joaoreser/Projeto-pcb-CRAO-Multifiltro/BOM_/AUTOOSCILANTE_BOM.xlsx

Name | Description | Designator | Footprint | LibRef | Quantity | Manufacturer | MPN | Supplier | Supplier P/N | Comments
~ | Capacitor de filme PP (FKP) – tanque ressonante (Cr) | C1, C2, C3, C4 | C_Rect_L18.0mm_W5.0mm_P15.00mm_FKS3_FKP3 | C_Small | 4 | WIMA | Série FKP3 (def. p/ valor) | Mouser | Definir conforme valor | Capacitores do tanque ressonante (Cr) — filme de polipropileno (FKP), passo 15 mm, alta tensão. Sugestão típica ~22 nF/630 V; valor final definido pelo projeto do conversor ressonante (algum deles pode ser bloqueio CC).
1uF | Capacitor de filme (MKS) 1 µF – filtro do barramento Vbus | C5 | C_Rect_L31.5mm_W11.0mm_P27.50mm_MKS4 | C_Small | 1 | WIMA | MKS4, 1 µF (conf. tensão) | Mouser | Buscar MKS4 1µF/630V | Capacitor de filtro do barramento Vbus, filme de poliéster (MKS4). Tensão nominal ≥ tensão do barramento (provavelmente 630 V).
~ | Capacitor de filme – filtro/snubber | C6 | C_Rect_L10.0mm_W4.0mm_P7.50mm_MKS4 | C_Small | 1 | WIMA | Série MKS4 (def. p/ valor) | Mouser | Definir conforme valor | Capacitor de filme pequeno (passo 7,5 mm). Valor a definir pelo esquemático (ex.: 100 nF).
C_Polarized_Small | Capacitor eletrolítico SMD – fonte auxiliar | C7, C8 | CP_Elec_6.3x5.7 | C_Polarized_Small | 2 | Panasonic | EEE-1HA100SR (10 µF/50 V) – conf. | Mouser | 667-EEE-1HA100SR (conf.) | Capacitor eletrolítico SMD (Ø6,3 mm) de filtro da alimentação/fonte auxiliar. Valor a confirmar (ex.: 10 µF/50 V).
~ | Capacitor cerâmico 0805 – desacople/filtro | C9, C11, C12, C13, C14, C15, C16, C17, C18, C19, C20 | C_0805_2012Metric_Pad1.18x1.45mm_HandSolder | C_Small | 11 | Yageo | CC0805KRX7R9BB104 (100 nF/50 V) | Mouser | 603-CC0805KRX7R9BB104 | Cerâmicos de desacople/filtro do controle (padrão 100 nF/50 V X7R). Atenção: alguns têm valor específico — ex.: filtro de saída do ACS712 (~1 nF, ver datasheet) e capacitores do L7805. Confirmar valores no esquemático.
C_Small | Capacitor cerâmico 1206 – bloco de partida | C10 | C_1206_3216Metric_Pad1.33x1.80mm_HandSolder | C_Small | 1 | Yageo | CC1206KKX7R9BB105 (1 µF/50 V) – conf. | Mouser | 603-CC1206KKX7R9BB105 (conf.) | Cerâmico 1206 (bloco de partida, junto à SW1). Valor a confirmar (ex.: 1 µF/50 V).
C_Polarized_Small | Capacitor eletrolítico radial – filtro de saída (Co) | Co1, Co2, Co3, Co4 | CP_Radial_D10.0mm_P5.00mm | C_Polarized_Small | 4 | Nichicon | UPW2A101MPD (100 µF/100 V) – conf. | Mouser | 647-UPW2A101MPD (conf.) | Capacitores eletrolíticos do filtro de saída (Co), radial Ø10 mm. Capacitância/tensão conforme Vo e ondulação desejada; tensão ≥ ~1,5× Vo (ex.: 4×100 µF/100 V).
D_Zener_Small_Filled | Diodo Zener (MELF) – grampo de gate | D1, D3, D8, D11 | D_MELF-RM10_Universal_Handsoldering | D_Zener_Small_Filled | 4 | Vishay | BZM55C15 (Zener 15 V, MELF) – conf. | Mouser | Buscar Zener MELF 15 V (conf.) | Diodos Zener de grampo dos gates do meio-ponte (HS/LS). Tensão típica 15 V (ajustar ao nível de gate/Vcc). Encapsulamento MELF.
D_Small_Filled | Diodo ultrarrápido (SMA) – gate / fonte aux. / controle | D2, D5, D6, D9, D12 | D_SMA_Handsoldering | D_Small_Filled | 5 | onsemi | US1M (ultrarrápido, 1 A/1000 V) | Mouser | 863-US1M | Diodos ultrarrápidos 1 A (SMA). D2/D9: acionamento de gate; D5/D6: retificação da fonte auxiliar; D12: controle. Para os de gate pode-se usar Schottky rápido (ex.: SS14) se a tensão reversa for baixa.
D_Small_Filled | Diodo retificador 1N4007 (DO-41) – partida | D4 | D_DO-41_SOD81_P7.62mm_Horizontal | D_Small_Filled | 1 | onsemi | 1N4007G | Mouser | 863-1N4007G | Diodo retificador 1000 V/1 A (DO-41) do circuito de partida (alimenta o startup a partir do Vbus).
DIAC | DIAC (DO-35) – disparo da partida | D7 | D_DO-35_SOD27_P7.62mm_Horizontal | DIAC | 1 | STMicroelectronics | DB3 | Mouser | 511-DB3 | DIAC de disparo da partida do oscilador (tensão de breakover ≈ 30–32 V). Encapsulamento DO-35.
D_Zener_Small_Filled | Diodo Zener (SMA) – regulação da Vcc auxiliar | D10 | D_SMA_Handsoldering | D_Zener_Small_Filled | 1 | onsemi | 1SMA5929BT3G (Zener 15 V/1,5 W) – conf. | Mouser | 863-1SMA5929BT3G (conf.) | Zener de regulação/grampo da tensão de alimentação auxiliar Vcc (≈15 V). Confirmar tensão conforme o projeto da fonte auxiliar.
D_Small_Filled | Diodo ultrarrápido (SMC) – retificador de saída | DR1, DR2, DR3, DR4 | D_SMC-RM10_Universal_Handsoldering | D_Small_Filled | 4 | onsemi | ES3J (ultrarrápido 3 A/600 V) – conf. | Mouser | 863-ES3J (conf.) | Diodos do retificador de saída em ponte completa (SMC/DO-214AB). Ultrarrápido 3 A/600 V; rever corrente/tensão conforme a saída. Alternativa Schottky (ex.: SK34/STPS) se Vo for baixa.
GND | Furo de fixação M3 – mecânico | H1, H2, H3, H4 | MountingHole_3.2mm_M3_Pad_Via | MountingHole_Pad | 4 | N/A | — | N/A | N/A | Furo de fixação M3 (Ø3,2 mm) com ilha/via — recurso mecânico da PCB, não é componente a comprar. Usar parafuso/espaçador M3.
Conn_01x02 | Terminal Faston PCB – saída | J1, J3 | Faston_5mm | Conn_01x02 | 2 | Keystone Electronics | 1287 (terminal Faston PCB) – conf. | Mouser | 534-1287 (conf.) | Terminal Faston de PCB para a saída (Vo / I+). Confirmar largura da lâmina (4,8 vs 6,3 mm) conforme o conector usado.
Vbus | Terminal Faston PCB – entrada Vbus | J2 | Faston_5mm | Conn_01x02 | 1 | Keystone Electronics | 1287 (terminal Faston PCB) – conf. | Mouser | 534-1287 (conf.) | Terminal Faston de PCB para a entrada do barramento Vbus (+).
GND | Terminal Faston PCB – GND | J4 | Faston_5mm | Conn_01x02 | 1 | Keystone Electronics | 1287 (terminal Faston PCB) – conf. | Mouser | 534-1287 (conf.) | Terminal Faston de PCB para GND/retorno.
Conn_01x02 | Borne a parafuso 2 vias, passo 5,08 mm | J5, J6 | KRE02 | Conn_01x02 | 2 | Phoenix Contact | 1715022 (MKDS 1,5/2-5,08) | Mouser | 651-1715022 | Borne a parafuso de 2 vias, passo 5,08 mm (J5: alimentação auxiliar externa; J6: sinal/saída do bloco). Alternativa econômica: KF301-5.0-2P (LCSC).
iR | Jumper de medição de corrente (iR) | JP1 | Jumper_Corrente_1mm | SolderJumper_2_Open | 1 | N/A | — | N/A | N/A | Jumper de medição de corrente "iR" — abrir o laço para inserir a ponteira de corrente, ou fechar com solda/0 Ω. Recurso de PCB (não é componente comprado).
iD1 | Jumper de medição de corrente (iD1) | JP2 | Jumper_Corrente_1mm | SolderJumper_2_Open | 1 | N/A | — | N/A | N/A | Jumper de medição de corrente "iD1" — abrir o laço para inserir a ponteira de corrente, ou fechar com solda/0 Ω. Recurso de PCB (não é componente comprado).
iSec | Jumper de medição de corrente (iSec) | JP3 | Jumper_Corrente_1mm | SolderJumper_2_Open | 1 | N/A | — | N/A | N/A | Jumper de medição de corrente "iSec" — abrir o laço para inserir a ponteira de corrente, ou fechar com solda/0 Ω. Recurso de PCB (não é componente comprado).
iD2 | Jumper de medição de corrente (iD2) | JP4 | Jumper_Corrente_1mm | SolderJumper_2_Open | 1 | N/A | — | N/A | N/A | Jumper de medição de corrente "iD2" — abrir o laço para inserir a ponteira de corrente, ou fechar com solda/0 Ω. Recurso de PCB (não é componente comprado).
SolderJumper_2_Open | Jumper de solda – configuração | JP5 | Jumper_Corrente_1mm | SolderJumper_2_Open | 1 | N/A | — | N/A | N/A | Jumper de solda de configuração — fechar/abrir conforme a montagem. Recurso de PCB (não é componente comprado).
iS1 | Jumper de medição de corrente (iS1) | JP6 | Jumper_Corrente_1mm | SolderJumper_2_Open | 1 | N/A | — | N/A | N/A | Jumper de medição de corrente "iS1" — abrir o laço para inserir a ponteira de corrente, ou fechar com solda/0 Ω. Recurso de PCB (não é componente comprado).
iS2 | Jumper de medição de corrente (iS2) | JP7 | Jumper_Corrente_1mm | SolderJumper_2_Open | 1 | N/A | — | N/A | N/A | Jumper de medição de corrente "iS2" — abrir o laço para inserir a ponteira de corrente, ou fechar com solda/0 Ω. Recurso de PCB (não é componente comprado).
~ | Indutor ressonante (Lr) – núcleo EFD25, fab. própria | L1 | EFD_25_13_09_PIN-1-2-10 | L | 1 | TDK / Ferroxcube (núcleo) + fab. própria | Núcleo EFD25/13/9 (N87/3C90) + carretel | Mouser (núcleo) | Definir (núcleo + carretel) | Indutor ressonante (Lr) — núcleo EFD25/13/9 em ferrite (ex.: TDK N87 / Ferroxcube 3C90) com carretel de 10 pinos. Bobinar conforme cálculo (indutância, nº de espiras, entreferro). Fabricação própria.
NMOS | MOSFET N 600 V (DPAK) – meio-ponte | M1, M2 | TO-252-2 | NMOS | 2 | onsemi (alt. Infineon) | FQD7N60CTF (600 V/7 A, DPAK) | Mouser | 512-FQD7N60CTF (conf.) | MOSFETs do meio-ponte (HS/LS), 600 V em DPAK/TO-252. Confirmar Rds(on)/corrente conforme a potência. Para LLC recomenda-se superjunção (ex.: Infineon CoolMOS IPD60R…P7).
BC817 | Transistor NPN BC817 (SOT-23) | Q1, Q2 | SOT-23 | BC817 | 2 | Nexperia | BC817-40,215 | Mouser | 771-BC817-40215 | Transistores NPN de uso geral (SOT-23, 45 V/0,5 A). Q1: regulação da alimentação auxiliar; Q2: bloco de controle.
~ | Resistor SMD 1206 – diversos (partida / leitura) | R1, R2, R3, R4, R5, R7, R8, R10, R11, R13, R14, R15, R21, R24, R25, R27, R38, R39 | R_1206_3216Metric_Pad1.30x1.75mm_HandSolder | R_Small | 18 | Yageo | Série RC1206 (def. p/ valor) | Mouser | Definir conforme valor | Resistores 1206 (0,25 W), valores a definir pelo esquemático. Inclui os de partida de alta tensão (R2/R5/R11 — alto valor; verificar tensão de trabalho) e o divisor de leitura de saída (R4/R10/R15). Tolerância 1% recomendada.
~ | Resistor SMD 0805 – acionamento de gate | R6, R9, R12, R17, R19, R20 | R_0805_2012Metric_Pad1.20x1.40mm_HandSolder | R_Small | 6 | Yageo | Série RC0805 (def. p/ valor) | Mouser | Definir conforme valor | Resistores 0805, valores a definir. Posições de acionamento de gate (R6/R9 e R12/R17/R19/R20) — tipicamente 10–47 Ω. Confirmar no esquemático.
10R | Resistor SMD 1206 – 10 Ω | R16, R44 | R_1206_3216Metric_Pad1.30x1.75mm_HandSolder | R_Small | 2 | Yageo | RC1206FR-0710RL (10 Ω, 1%) | Mouser | 603-RC1206FR-0710RL | Resistores 10 Ω/1206. R16: limitação/leitura na fonte auxiliar; R44: bloco de controle.
3k6 | Resistor SMD 0805 – 3,6 kΩ | R18 | R_0805_2012Metric_Pad1.20x1.40mm_HandSolder | R_Small | 1 | Yageo | RC0805FR-073K6L (3,6 kΩ, 1%) | Mouser | 603-RC0805FR-073K6L | Resistor 3,6 kΩ/0805 (polarização da fonte auxiliar — junto ao Q1/Zener).
10R | Resistor SMD 0805 – malha de controle | R22, R23, R26, R28, R29, R30, R31, R32, R33, R34, R35, R36, R37, R40, R41, R42, R43, R45, R46, R47, R48 | R_0805_2012Metric_Pad1.20x1.40mm_HandSolder | R_Small | 21 | Yageo | RC0805FR-0710RL (10 Ω) – ver obs. | Mouser | 603-RC0805FR-0710RL | ATENÇÃO: 21 resistores 0805 marcados como "10 Ω" — provavelmente é o valor padrão do Altium ainda não editado. Na malha de controle (ganhos dos amp. op., divisores, referência, dimming) os valores normalmente são diferentes (ex.: 1k–100k). Conferir/atualizar cada valor no esquemático antes de comprar; o MPN segue o valor real.
R_Potentiometer_Small | Trimpot multivoltas 3296W – ajustes | RV1, RV2 | Potentiometer_Bourns_3296W_Vertical | R_Potentiometer_Small | 2 | Bourns | 3296W-1-103LF (10 kΩ) – conf. | Mouser | 652-3296W-1-103LF (conf.) | Trimpots multivoltas 3296W (vertical). RV1: ajuste de corrente máxima ("SET Max"); RV2: ajuste de dimming/referência. Resistência conforme projeto (ex.: 10 kΩ ou 100 kΩ).
SW_Push | Chave tátil 6 mm – partida / reset | SW1 | SW_SPST_PTS645 | SW_Push | 1 | C&K | PTS645SK50SMTR92 LFS – conf. | Mouser | 611-PTS645SK50SMTR92 (conf.) | Chave tátil 6 mm (partida/reset manual). Alternativa: tact 6×6 mm genérico (LCSC).
VdHS | Ponto de teste (laço) – VdHS | TP1 | TestPoint_Loop_D1.80mm_Drill1.0mm_Beaded | TestPoint_Probe | 1 | Keystone Electronics | 5011 (ponto de teste de laço) | Mouser | 534-5011 | Ponto de teste (laço) para medição — sinal "VdHS" (ver coluna Value). Pode ser substituído por um laço de fio soldado.
Rac1 | Ponto de teste (laço) – Rac1 | TP2 | TestPoint_Loop_D1.80mm_Drill1.0mm_Beaded | TestPoint_Probe | 1 | Keystone Electronics | 5011 (ponto de teste de laço) | Mouser | 534-5011 | Ponto de teste (laço) para medição — sinal "Rac1" (ver coluna Value). Pode ser substituído por um laço de fio soldado.
VgHS | Ponto de teste (laço) – VgHS | TP3 | TestPoint_Loop_D1.80mm_Drill1.0mm_Beaded | TestPoint_Probe | 1 | Keystone Electronics | 5011 (ponto de teste de laço) | Mouser | 534-5011 | Ponto de teste (laço) para medição — sinal "VgHS" (ver coluna Value). Pode ser substituído por um laço de fio soldado.
Rac2 | Ponto de teste (laço) – Rac2 | TP4 | TestPoint_Loop_D1.80mm_Drill1.0mm_Beaded | TestPoint_Probe | 1 | Keystone Electronics | 5011 (ponto de teste de laço) | Mouser | 534-5011 | Ponto de teste (laço) para medição — sinal "Rac2" (ver coluna Value). Pode ser substituído por um laço de fio soldado.
VsHS | Ponto de teste (laço) – VsHS | TP5 | TestPoint_Loop_D1.80mm_Drill1.0mm_Beaded | TestPoint_Probe | 1 | Keystone Electronics | 5011 (ponto de teste de laço) | Mouser | 534-5011 | Ponto de teste (laço) para medição — sinal "VsHS" (ver coluna Value). Pode ser substituído por um laço de fio soldado.
VdLS | Ponto de teste (laço) – VdLS | TP6 | TestPoint_Loop_D1.80mm_Drill1.0mm_Beaded | TestPoint_Probe | 1 | Keystone Electronics | 5011 (ponto de teste de laço) | Mouser | 534-5011 | Ponto de teste (laço) para medição — sinal "VdLS" (ver coluna Value). Pode ser substituído por um laço de fio soldado.
VgLS | Ponto de teste (laço) – VgLS | TP7 | TestPoint_Loop_D1.80mm_Drill1.0mm_Beaded | TestPoint_Probe | 1 | Keystone Electronics | 5011 (ponto de teste de laço) | Mouser | 534-5011 | Ponto de teste (laço) para medição — sinal "VgLS" (ver coluna Value). Pode ser substituído por um laço de fio soldado.
VsLS | Ponto de teste (laço) – VsLS | TP8 | TestPoint_Loop_D1.80mm_Drill1.0mm_Beaded | TestPoint_Probe | 1 | Keystone Electronics | 5011 (ponto de teste de laço) | Mouser | 534-5011 | Ponto de teste (laço) para medição — sinal "VsLS" (ver coluna Value). Pode ser substituído por um laço de fio soldado.
Earth | Ponto de teste (laço) – Earth | TP9 | TestPoint_Loop_D1.80mm_Drill1.0mm_Beaded | TestPoint_Probe | 1 | Keystone Electronics | 5011 (ponto de teste de laço) | Mouser | 534-5011 | Ponto de teste (laço) para medição — sinal "Earth" (ver coluna Value). Pode ser substituído por um laço de fio soldado.
GND | Ponto de teste (laço) – GND | TP10 | TestPoint_Loop_D1.80mm_Drill1.0mm_Beaded | TestPoint_Probe | 1 | Keystone Electronics | 5011 (ponto de teste de laço) | Mouser | 534-5011 | Ponto de teste (laço) para medição — sinal "GND" (ver coluna Value). Pode ser substituído por um laço de fio soldado.
y | Pad de teste SMD – y | TP11 | Test Pad SMD | TestPoint_Probe | 1 | N/A | — | N/A | N/A | Pad de teste SMD do controle — sinal "y" (ver coluna Value). Sem componente a montar.
erro | Pad de teste SMD – erro | TP12 | Test Pad SMD | TestPoint_Probe | 1 | N/A | — | N/A | N/A | Pad de teste SMD do controle — sinal "erro" (ver coluna Value). Sem componente a montar.
ref | Pad de teste SMD – ref | TP13 | Test Pad SMD | TestPoint_Probe | 1 | N/A | — | N/A | N/A | Pad de teste SMD do controle — sinal "ref" (ver coluna Value). Sem componente a montar.
TRX_LLC_16pin | Transformador LLC – núcleo EE35, fab. própria | TR1 | EE_35_18_12 | TRX_LLC_16pin_2aux | 1 | TDK / Ferroxcube (núcleo) + fab. própria | Núcleo EE35/18/12 (N87/3C90) + carretel 16 pinos | Mouser (núcleo) | Definir (núcleo + carretel) | Transformador principal do conversor LLC — núcleo EE35/18/12 em ferrite, carretel de 16 pinos. Primário + secundário + 2 enrolamentos auxiliares; relação de espiras, Lm e Lr conforme projeto. Fabricação própria.
L7805 | Regulador linear +5 V L7805 (DPAK) | U1 | TO-252-3_TabPin2 | L7805 | 1 | STMicroelectronics | L7805CDT-TR | Mouser | 511-L7805CDT-TR | Regulador linear +5 V (DPAK) — alimenta o ACS712 e parte do controle.
ACS712xLCTR-05B | Sensor de corrente Hall ACS712 ±5 A (SOIC-8) | U2 | SOIC-8_3.9x4.9mm_P1.27mm | ACS712xLCTR-05B | 1 | Allegro MicroSystems | ACS712ELCTR-05B-T | Mouser | 634-ACS712ELCTR-05B-T | Sensor de corrente por efeito Hall, faixa ±5 A, sensibilidade ~185 mV/A (SOIC-8). Mede a corrente de saída.
Opamp_Quad | Amp. operacional quádruplo (SOIC-14) – controlador | U3 | SOIC-14_3.9x8.7mm_P1.27mm | Opamp_Quad | 1 | Texas Instruments | LM324DR | Mouser | 595-LM324DR | Amplificador operacional quádruplo do controlador (U3A–U3D: malha de erro, condicionamento da corrente, dimming 0–10 V). Para excursão rail-to-rail em 5 V, considerar MCP6004/TLV9004.
VCT | Transformador de corrente (VCT) – 2 toroides, fab. própria | VCT1 | Toroidal_2xD12.5mm_VCT | CT_LP_LS1_LS2_Laux | 1 | Fair-Rite / Ferroxcube (toroides) + fab. própria | 2× toroide de ferrite Ø12,5 mm | Mouser (toroides) | Definir (toroides) | Transformador de corrente (VCT) do acionamento autooscilante — 2 toroides de ferrite Ø12,5 mm. Gera o sinal de comando do meio-ponte a partir da corrente do tanque; relação de espiras conforme projeto. Fabricação própria.
