joaoreser/Projeto-pcb-CRAO-Multifiltro/Pdf_esquematico/Esquematico_PCB.pdf

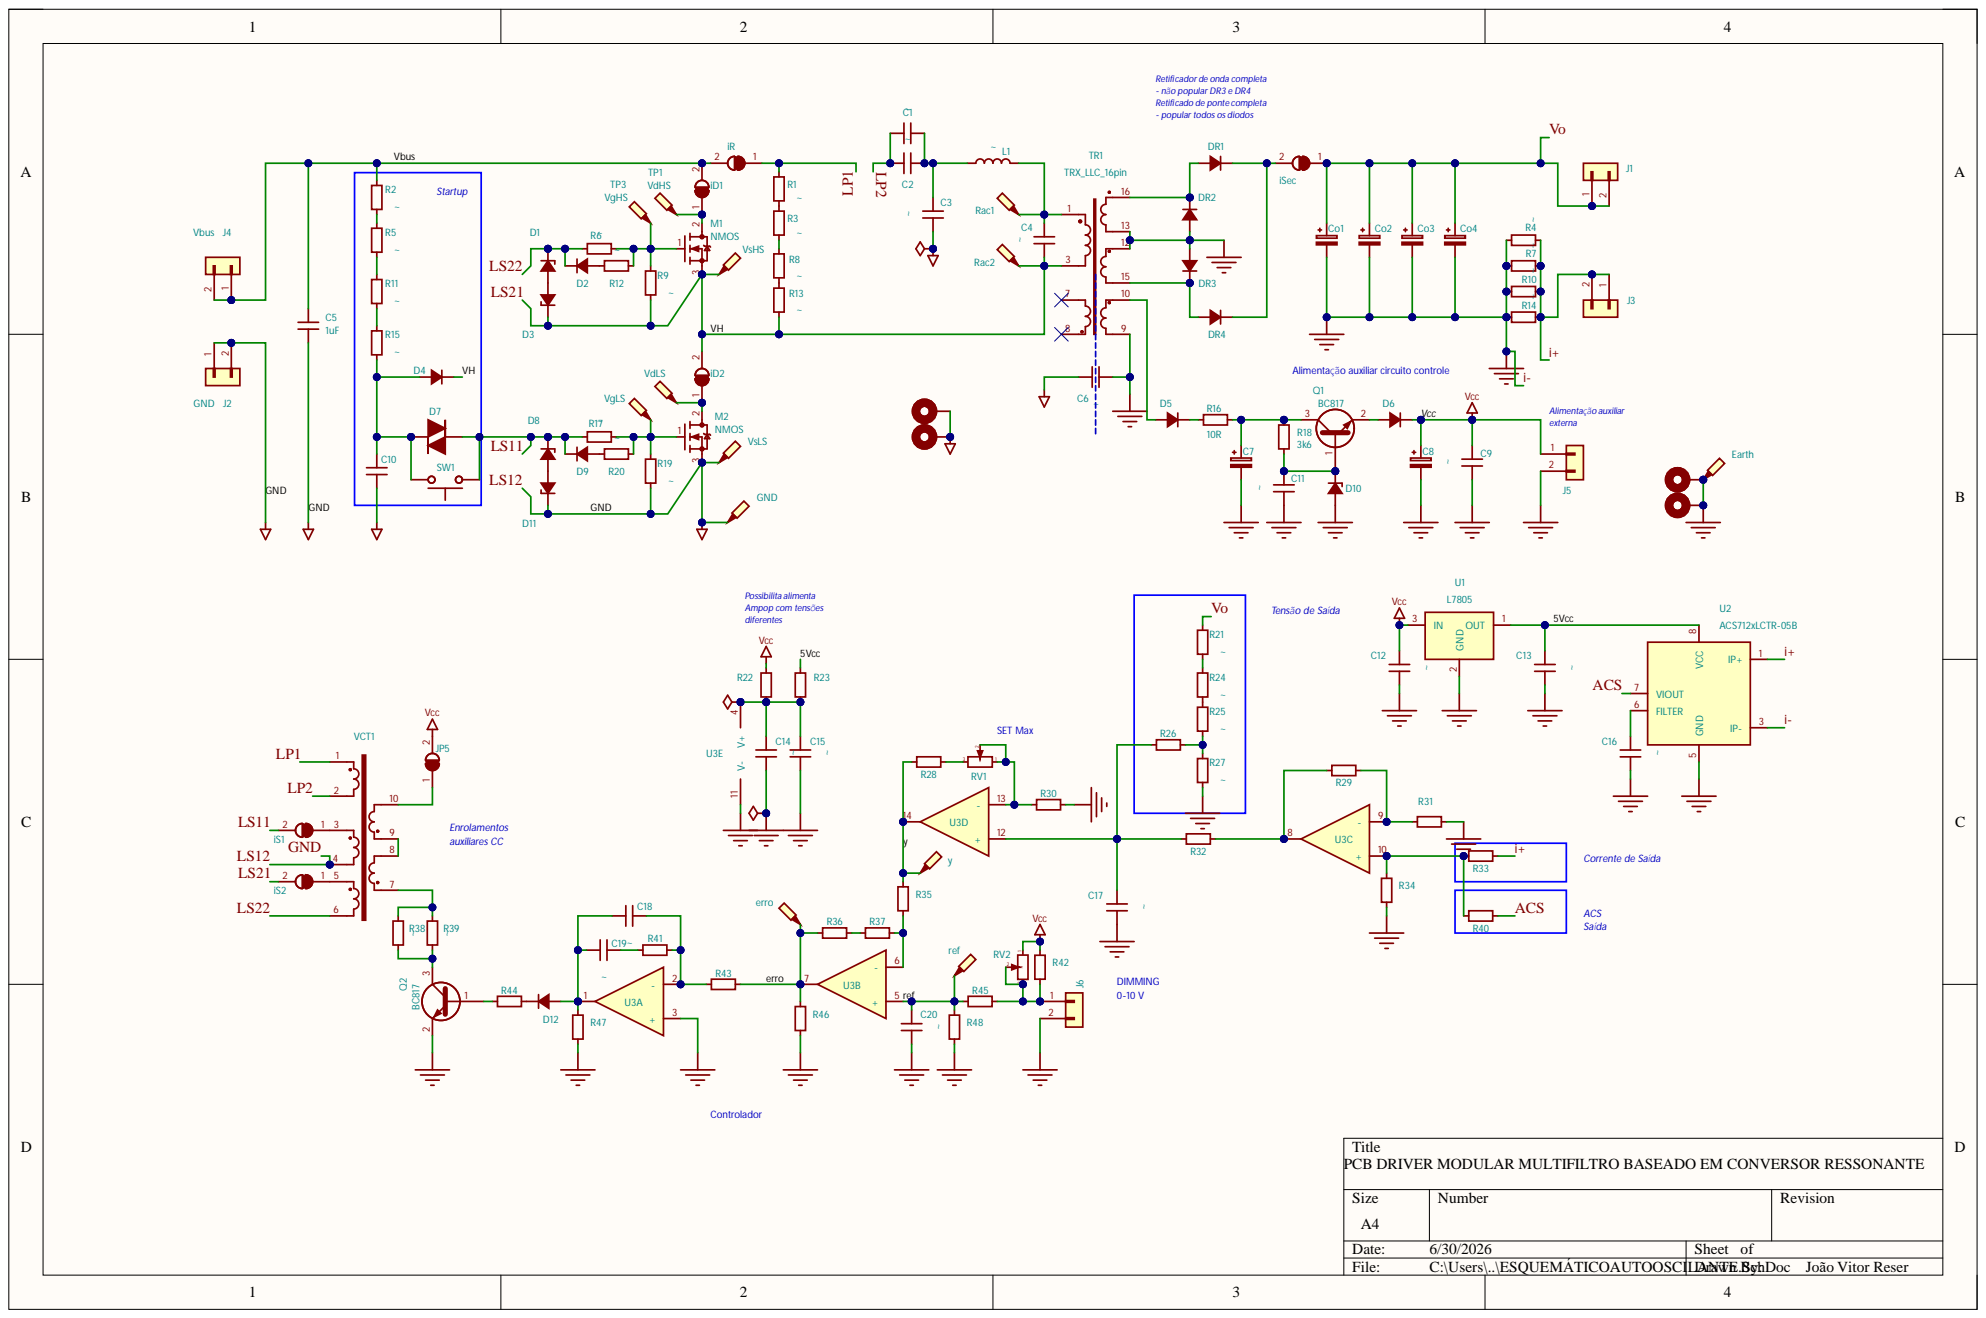
[picture p1: page 1]

Retificador de onda completa
- não popular DR3 e DR4
Retificado de ponte completa
- popular todos os diodos

Alimentação auxiliar circuito controle

Title
PCB DRIVER MODULAR MULTIFILTRO BASEADO EM CONVERSOR RESSONANTE

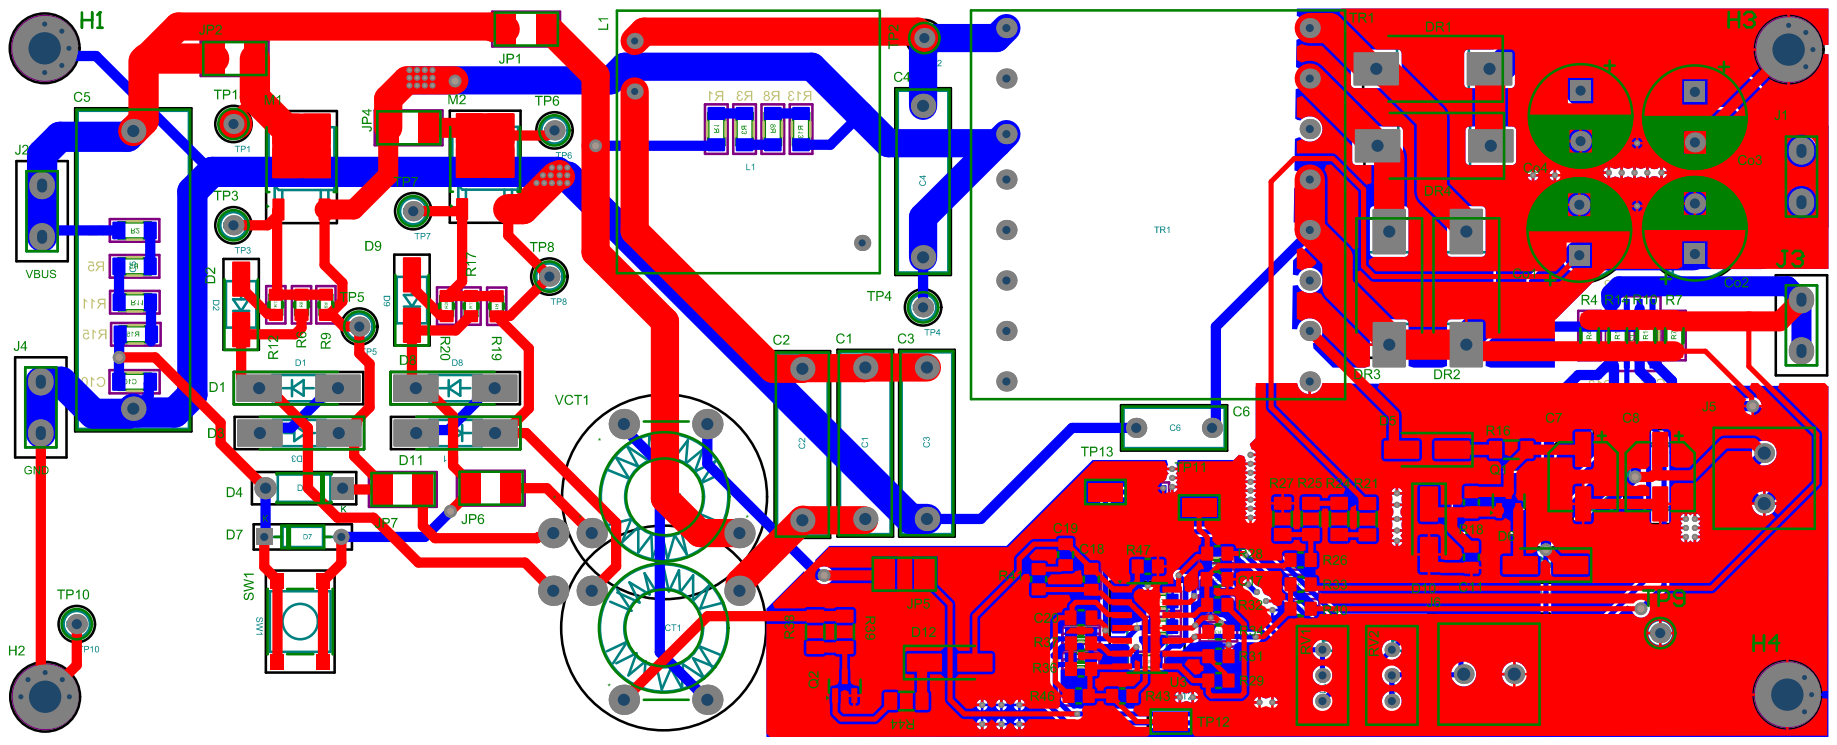
[picture p2: page 2]
