joaoreser/Projeto-pcb-CRAO-Multifiltro/(list of files, drawings)

Other design files:
Projeto_Completo/AUTOOSCILANTE_NOVO.PrjPcb
Projeto_Completo/ESQUEMÁTICOAUTOOSCILANTE.SchDoc
Projeto_Completo/PCB_AUTOOSCILANTE.PcbDoc
